dpatel774/Robotic-arm-w-inverse-kinematics/docs/arm-preview.gif

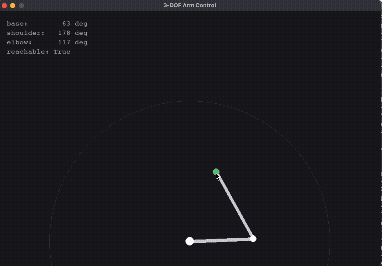
docs/arm-preview.gif
