dpatel774/Robotic-arm-w-inverse-kinematics/docs/cad-render.png

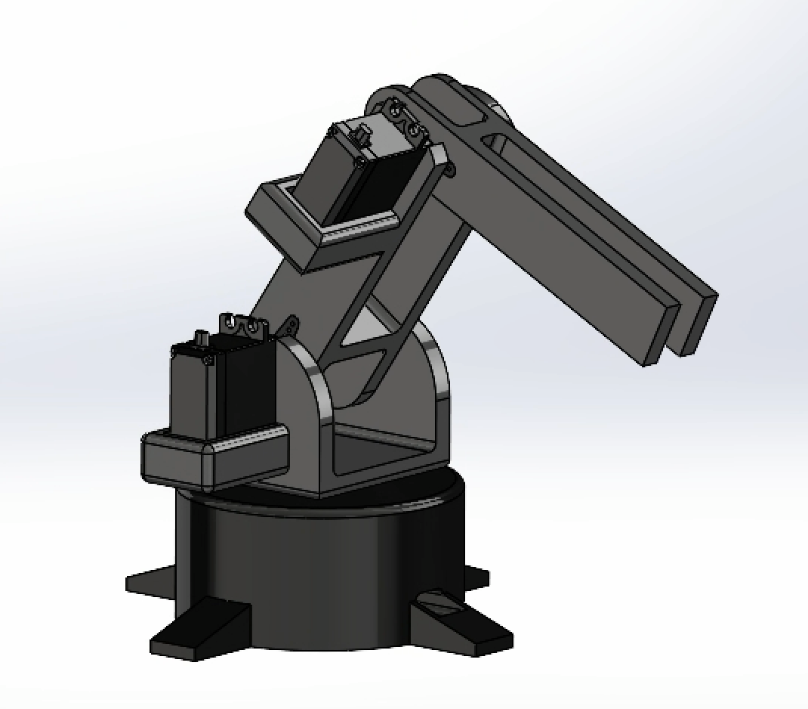
docs/cad-render.png
