dpatel774/Robotic-arm-w-inverse-kinematics/docs/Robot Arm BOM.xlsx

3-DOF Desktop Robotic Arm — Bill of Materials
Yellow cells = fill in with actual values (e.g. print costs, real vendor prices).
Item | Category | Qty | Unit Cost ($) | Total Cost ($) | Notes / Specs
ELEGOO UNO R3 (CH340 clone) | Electronics | 1 | $13.29 | $13.29 | Arduino Uno-compatible board, CH340 USB-serial chip; runs arm_controller.ino
PCA9685 16-Channel PWM Driver | Electronics | 1 | $7.00 | $7.00 | I2C address 0x40; drives servos on channels 0-3 (ch3 reserved for future SG90 claw)
MG995 Servo | Electronics | 3 | $8.00 | $14.00 | Base rotation, shoulder, elbow (channels 0/1/2); ~13 kg-cm torque, 5-6V max
5V DC Power Supply | Electronics | 1 | $11.00 | $5.00 | 5V, 4A+ recommended for 3x MG995 headroom; DO NOT use 24V source — servos/PCA9685 rated 5-6V max
Dupont Jumper Wire Kit + Power Wiring | Electronics | 1 | $7.00 | $7.00 | M-F/M-M/F-F jumpers for I2C + signal lines; shared ground runs through PCA9685 GND
Base | 3D Printed Structure | 1 |  | $0.00 | Holds first servo
Upper Arm Link (First Arm) | 3D Printed Structure | 1 |  | $0.00 | 10 cm length; horn pocket +0.25mm offset, M3 heat-set inserts; single continuous shoulder mount body
Revolution hold | 3D Printed Structure | 1 |  | $0.00 | 180 degree rotated on the base
Forearm Link (Second Arm) | 3D Printed Structure | 1 |  | $0.00 | 12 cm length (22 cm total reach); elbow mount single continuous body, flipped horn orientation
TOTAL |  |  |  | $46.29
Assumptions:
- Electronics prices are current typical online-marketplace estimates (July 2026), not confirmed vendor quotes.
- Claw (SG90, PCA9685 channel 3) is a deferred v2 item and is not included in this BOM.
- 3D-printed part costs are left blank (yellow) pending actual filament weight x CAEN per-gram rate.
- Power supply sized for 3x MG995 stall-current headroom; confirm against final duty cycle before purchase.
