dpatel774/Robotic-arm-w-inverse-kinematics/docs/wiring-diagram.png

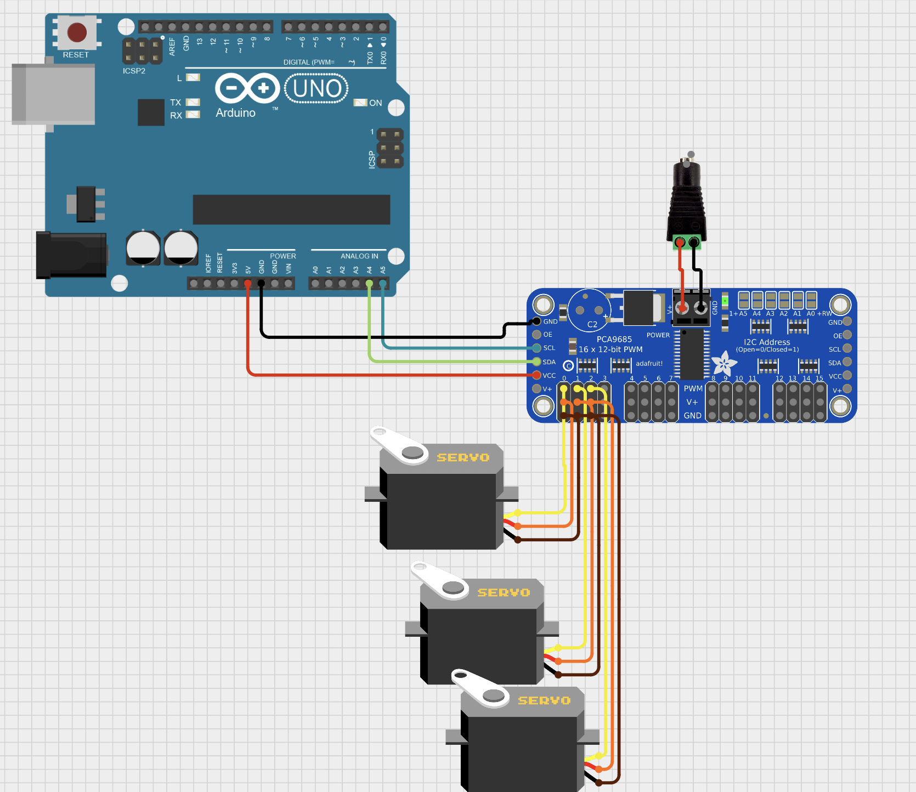
docs/wiring-diagram.png
