dpatel774/Robotic-arm-w-inverse-kinematics/(commit log)

2026-07-21 Add wiring diagram and writeup to hardware section
2026-07-23 Add mechanical design section with CAD render
2026-07-23 Add BOM to docs folder for Pages
    [Robot Arm BOM.xlsx]
